ingmarsretro/nixieclock/pictures/acrylcover.jpg

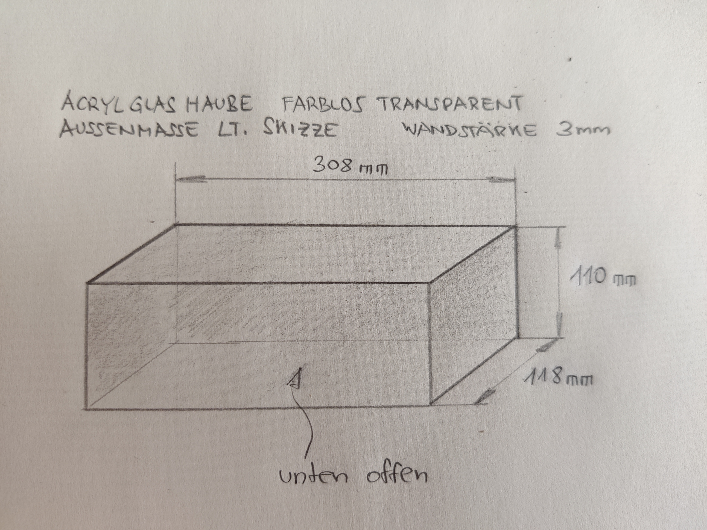
pictures/acrylcover.jpg
