ingmarsretro/nixieclock/pictures/nixieclock.jpg

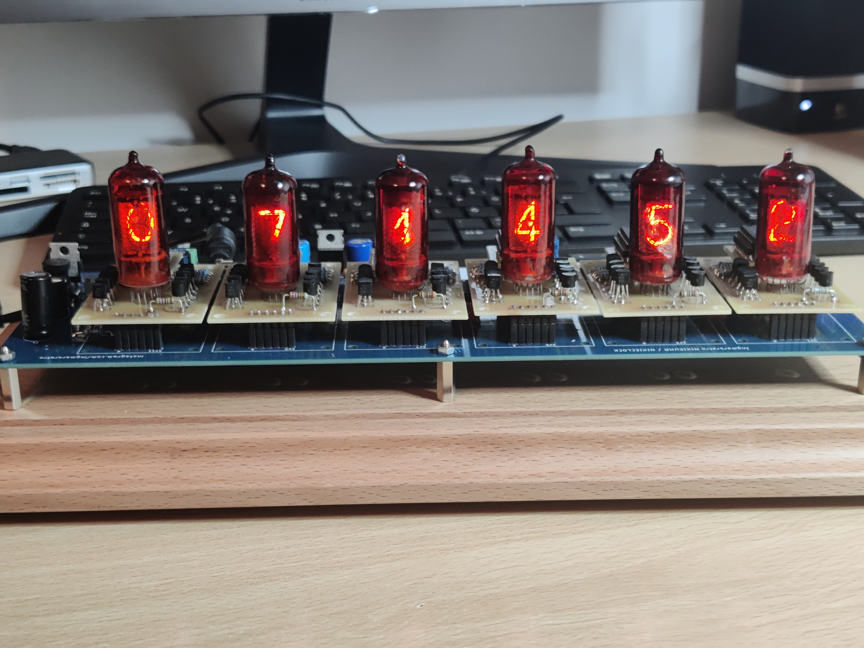
pictures/nixieclock.jpg
