ingmarsretro/nixieclock/README.md

# nixieclock
it is a project for a simple nixieclock hardware and software design based on atmega 8bit controller

develpment environment for this project below:
- Arduino IDE 
- Autodesk Eagle schematic and layout tool for pcb design

all files are hosted here in these folders
