ingmarsretro/nixieclock/board_eagle/Nixieclock_schematic_v3.7.pdf

SpiceOrder 2 | SpiceOrder 1 | SpiceOrder 1 SpiceOrder 2

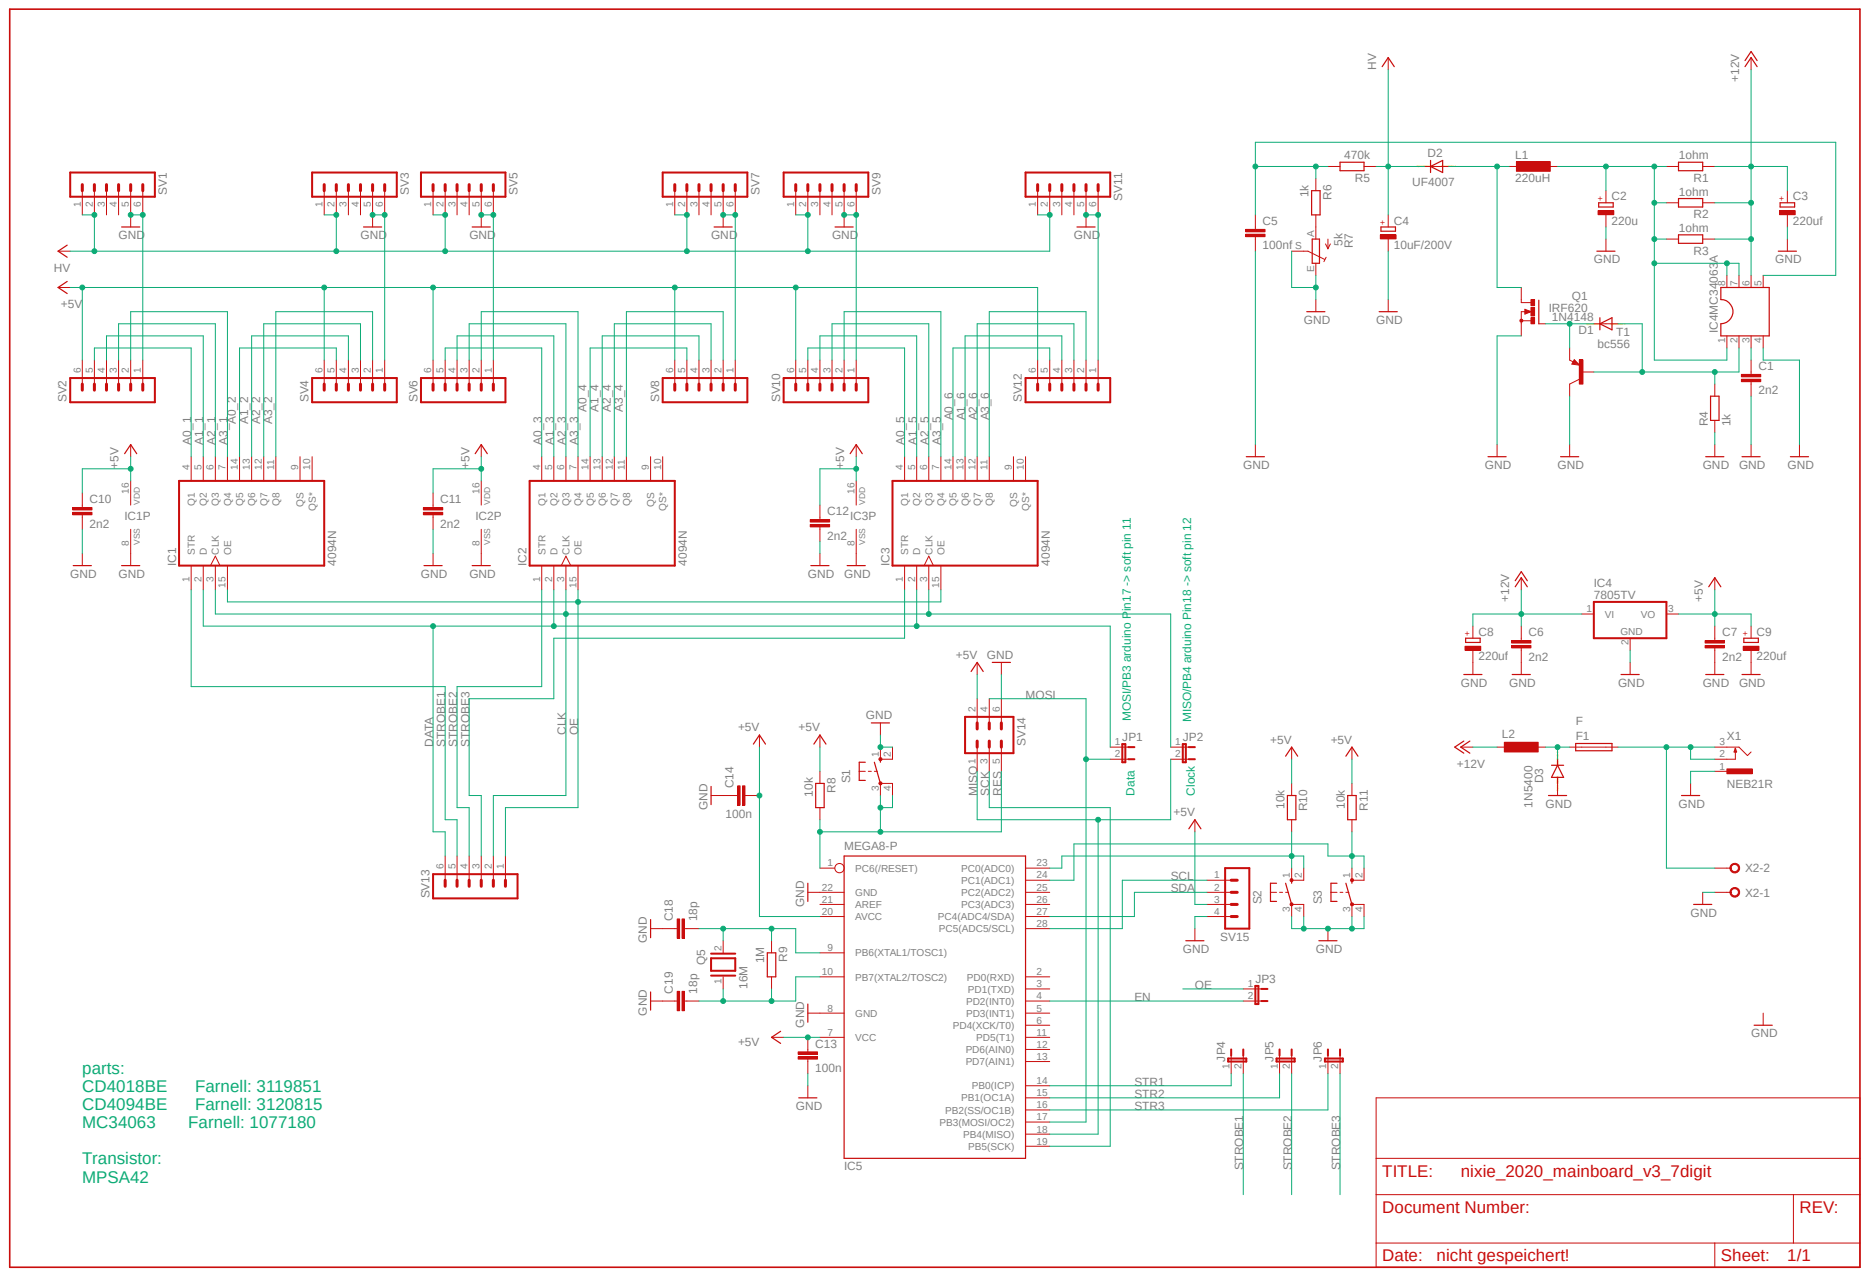
[picture p3: page 1]

9 QS* 10 Q8 11 Q7 12 Q6 13 Q5 14 OE 15 IC1 VDD 8 16 VSS

9 QS* 10 Q8 11 Q7 12 Q6 13 Q5 14 OE 15 IC3 VDD 8 16 VSS

+ MOSI/PB3 arduino Pin17 -> soft pin 11 Data Clock MISO/PB4 arduino Pin18 -> soft pin 12

STR2
STR3

Document Number: | REV:

Date: nicht gespeichert! | Sheet: 1/1
