ingmarsretro/nixieclock/schematics/schematic_mainboard.pdf

SpiceOrder 2 | SpiceOrder 1 | SpiceOrder 1 SpiceOrder 2

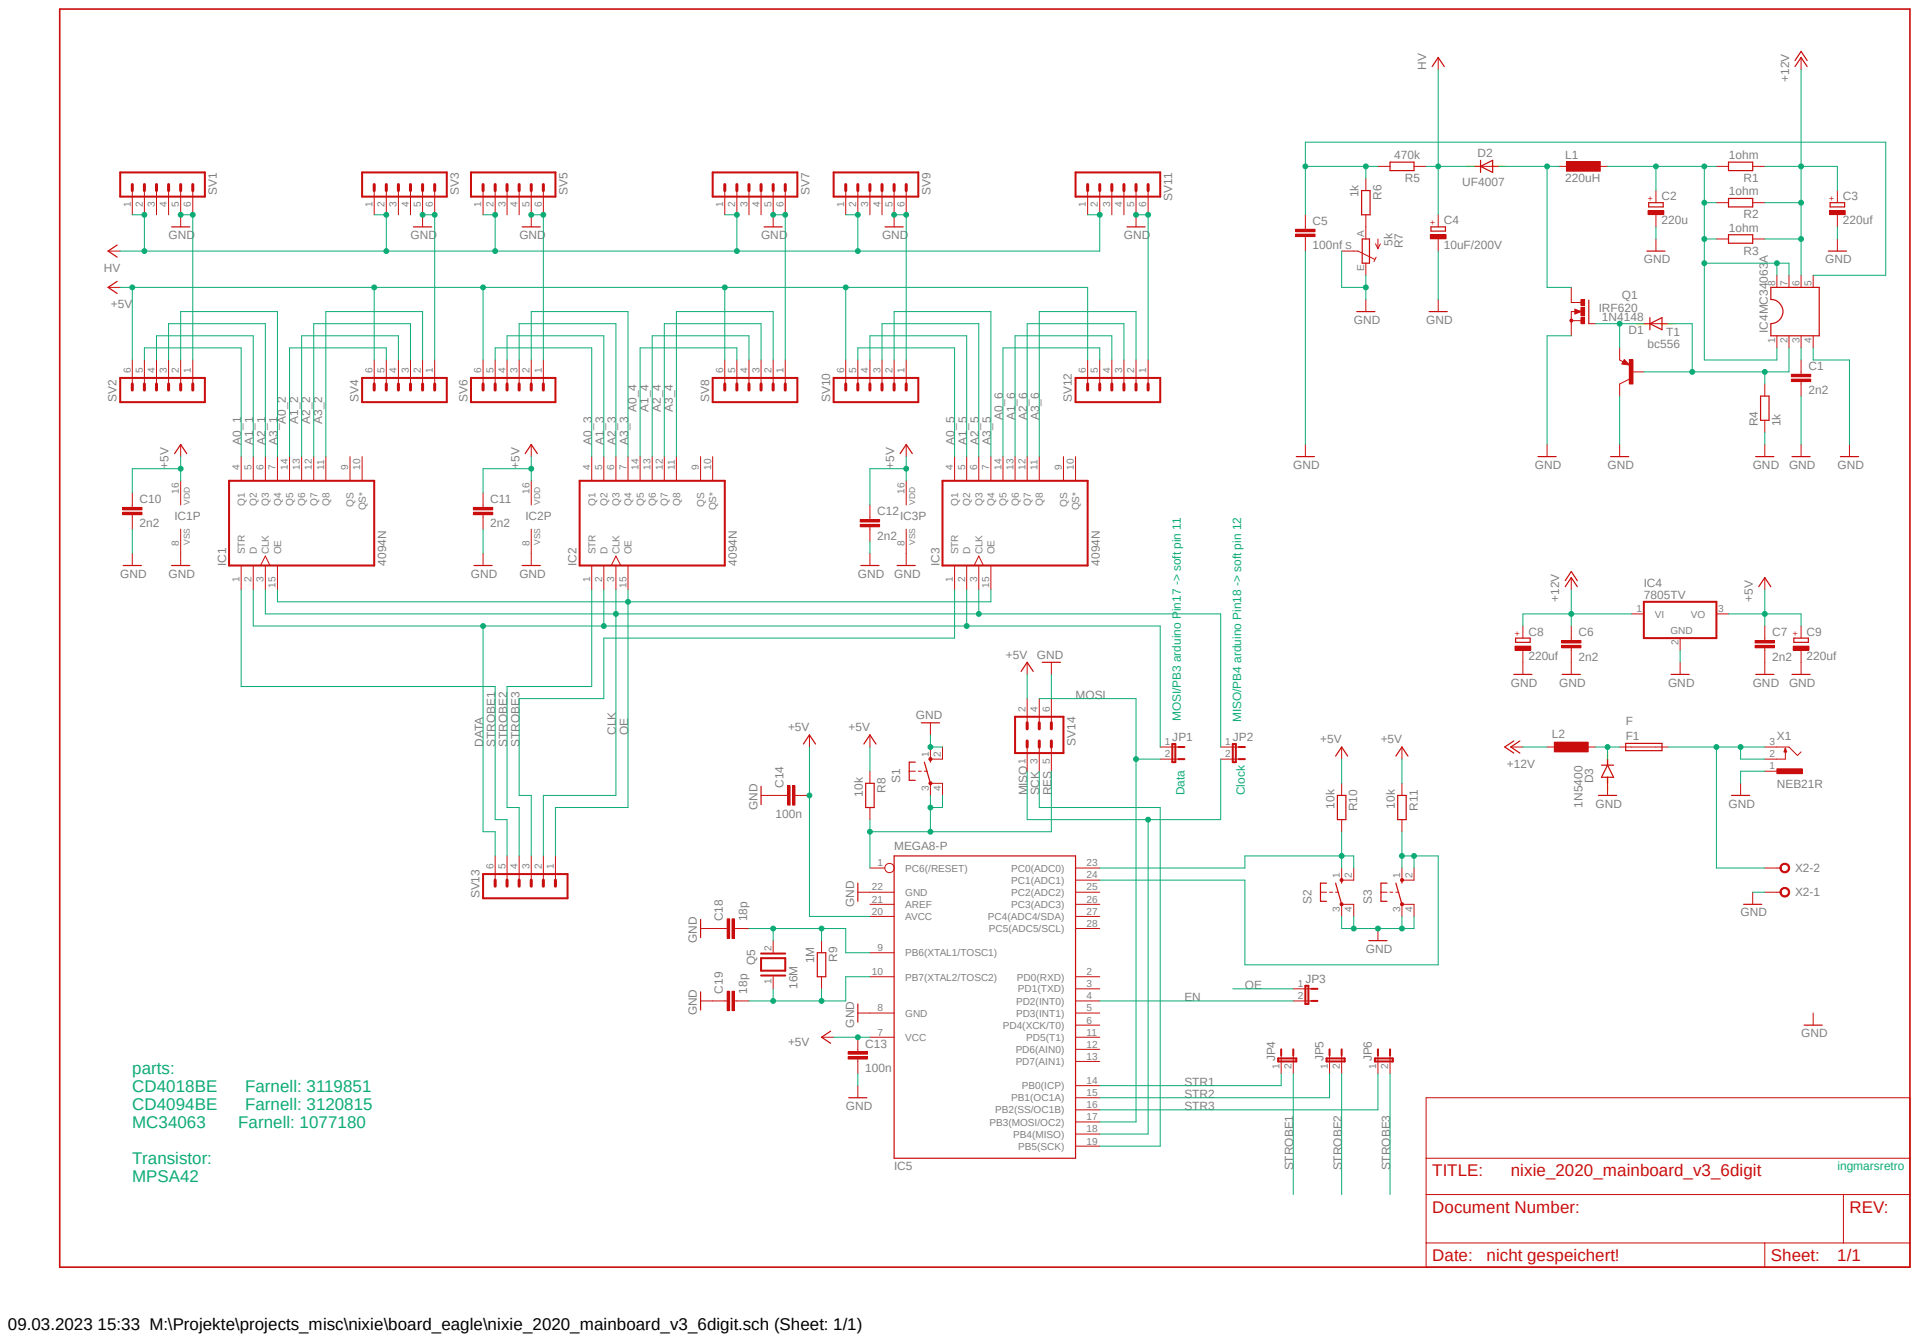
[picture p4: page 1]
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

+ MOSI/PB3 arduino Pin17 -> soft pin 11 Data Clock MISO/PB4 arduino Pin18 -> soft pin 12

STR2
STR3

Document Number: | REV:

Date: nicht gespeichert! | Sheet: 1/1

09.03.2023 15:33 M:\Projekte\projects_misc\nixie\board_eagle\nixie_2020_mainboard_v3_6digit.sch (Sheet: 1/1)
