ingmarsretro/nixieclock/schematics/schematic_tubeboard.pdf

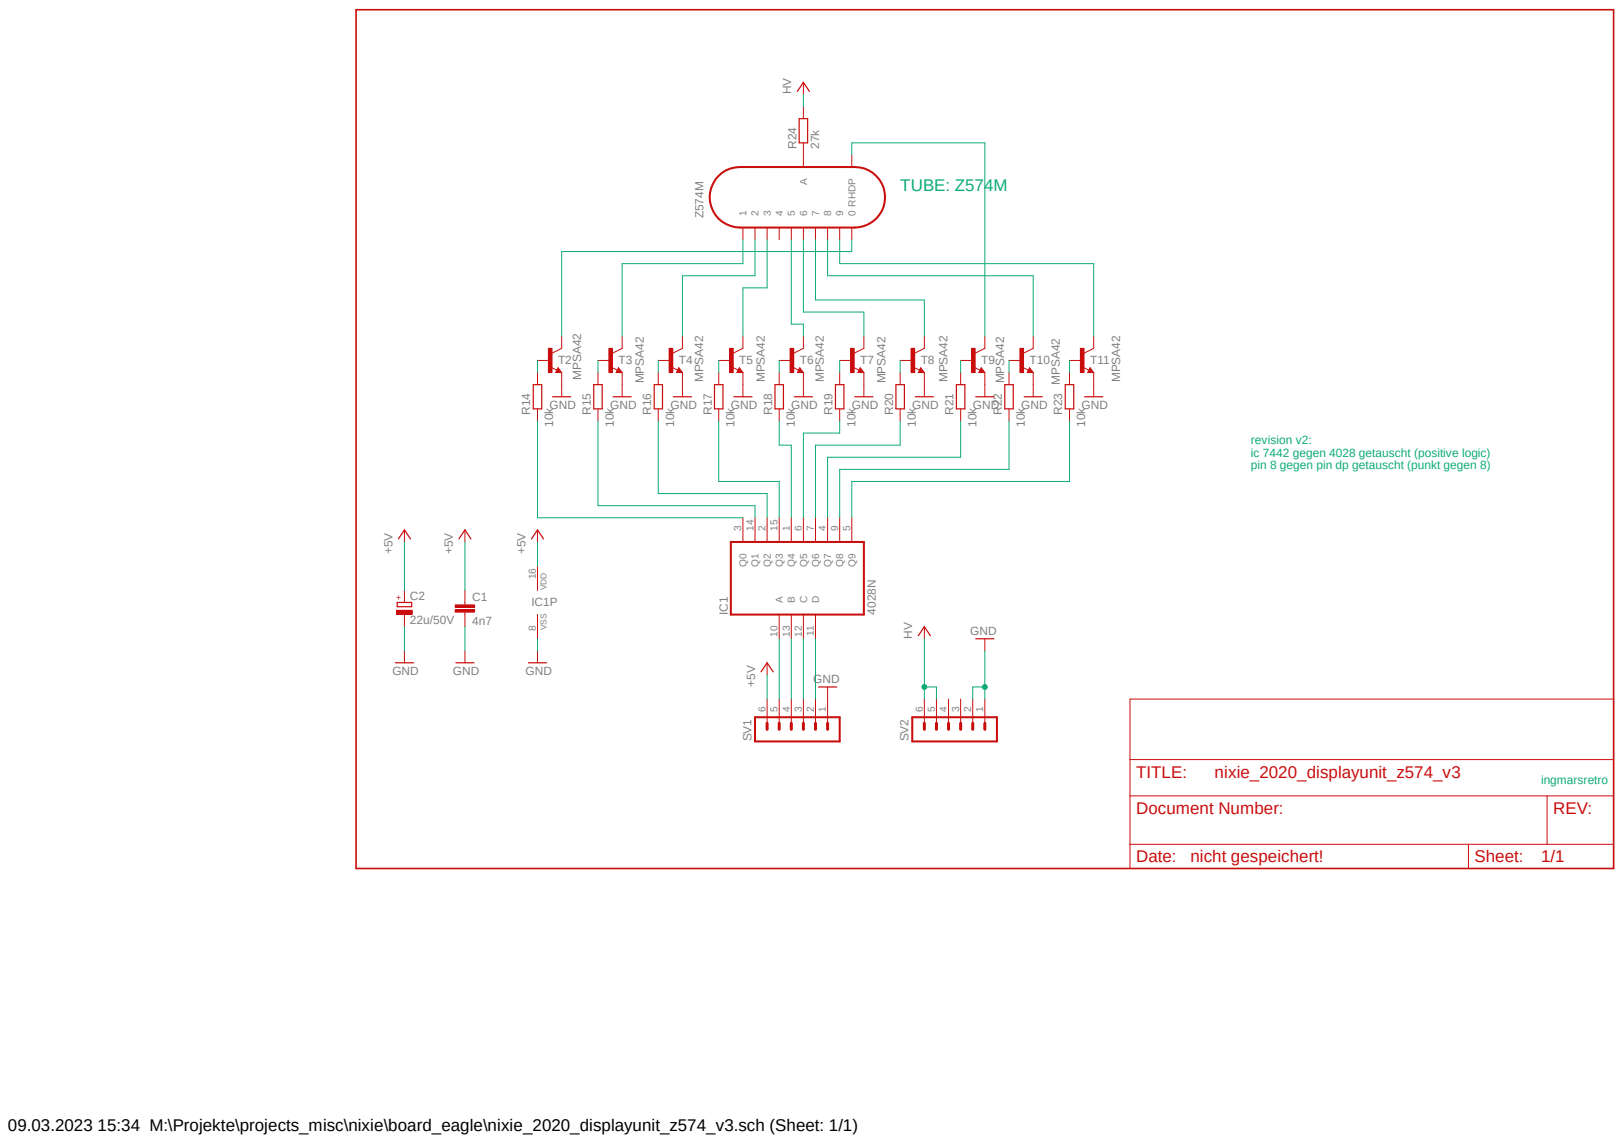
[picture p5: page 1]

revision v2:
ic 7442 gegen 4028 getauscht (positive logic)
pin 8 gegen pin dp getauscht (punkt gegen 8)

Document Number: | REV:

Date: nicht gespeichert! | Sheet: 1/1

09.03.2023 15:34 M:\Projekte\projects_misc\nixie\board_eagle\nixie_2020_displayunit_z574_v3.sch (Sheet: 1/1)
