ingmarsretro/nixieclock/board_eagle/nixie_2020_mainboard_v3_7digit.brd

## EAGLE design board_eagle/nixie_2020_mainboard_v3_7digit.brd (2023-10-31)

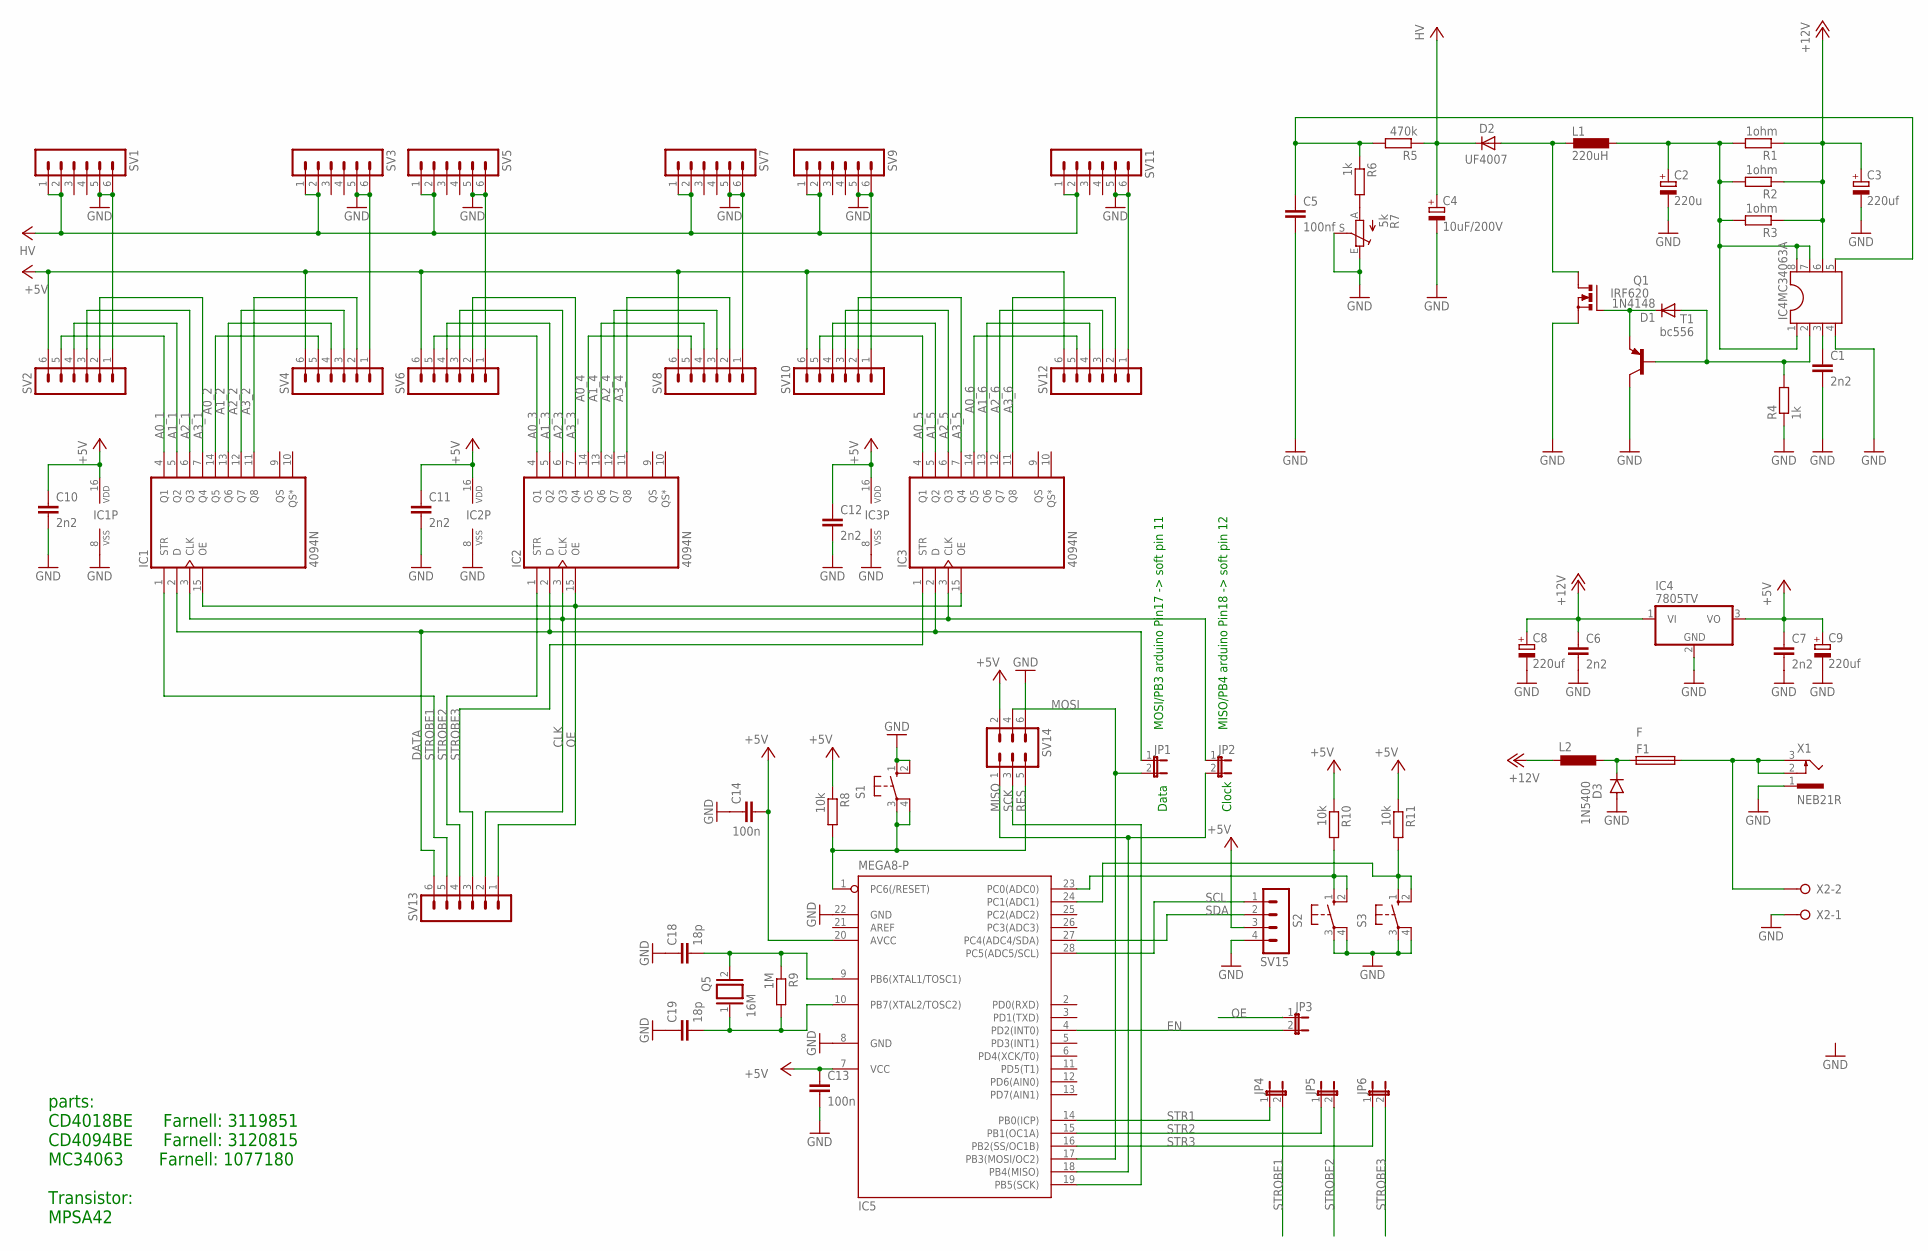
[picture p6: schematic nixie_2020_mainboard_v3_7digit.sch]

Parts:
C1, C6, C7, C10, C11, C12: 2n2; C050-030X075
C2: 220u; E5-10,5
C3, C8, C9: 220uf; E5-10,5
C4: 10uF/200V; E5-10,5
C5: 100nf; C075-042X103
C13, C14: 100n; C050-025X075
C18, C19: 18p; C050-025X075
D1: 1N4148; DO35-10
D2: UF4007; DO35-10
D3: 1N5400; DO201-15
F1: F; SHK20L
IC1, IC2, IC3: 4094N; DIL16
IC4: 7805TV; TO220V
IC4MC34063A: DIL8S; SOCKET-08
IC5: MEGA8-P; DIL28-3
JP1, JP2, JP3, JP4, JP5, JP6: JP1E; JP1
L1: 220uH; LAN02KR
L2: L-EU0207/10; 0207/10
Q1: IRF620; TO220BV
Q5: 16M; QS
R1, R2, R3: 1ohm; 0207/12
R4, R6: 1k; 0207/12
R5: 470k; 0207/12
R7: 5k; RJ9W
R8, R10, R11: 10k; 0207/12
R9: 1M; 0207/12
S1, S2, S3: 10-XX; B3F-10XX
SV1, SV2, SV3, SV4, SV5, SV6, SV7, SV8, SV9, SV10, SV11, SV12, SV13: MA06-1
SV14: MA03-2
SV15: MA04-1
T1: bc556; TO92-EBC
X1: NEB21R
X2: W237-02P; W237-132

Connections:
+5V: C7.1, C9.+, C10.1, C11.1, C12.1, C13.1, C14.2, IC1.16 (VDD), IC2.16 (VDD), IC3.16 (VDD), IC4.3 (VO), IC5.7 (VCC), IC5.20 (AVCC), R8.1, R10.1, R11.1, SV2.6, SV4.6, SV6.6, SV8.6, SV10.6, SV12.6, SV14.2, SV15.3
+12V: C3.+, C6.1, C8.+, IC4.1 (VI), IC4MC34063A.6, L2.1, R1.1, R2.1, R3.1
A0_1: IC1.4 (Q1), SV2.5
A0_2: IC1.14 (Q5), SV4.5
A0_3: IC2.4 (Q1), SV6.5
A0_4: IC2.14 (Q5), SV8.5
A0_5: IC3.4 (Q1), SV10.5
A0_6: IC3.14 (Q5), SV12.5
A1_1: IC1.5 (Q2), SV2.4
A1_2: IC1.13 (Q6), SV4.4
A1_3: IC2.5 (Q2), SV6.4
A1_4: IC2.13 (Q6), SV8.4
A1_5: IC3.5 (Q2), SV10.4
A1_6: IC3.13 (Q6), SV12.4
A2_1: IC1.6 (Q3), SV2.3
A2_2: IC1.12 (Q7), SV4.3
A2_3: IC2.6 (Q3), SV6.3
A2_4: IC2.12 (Q7), SV8.3
A2_5: IC3.6 (Q3), SV10.3
A2_6: IC3.12 (Q7), SV12.3
A3_1: IC1.7 (Q4), SV2.2
A3_2: IC1.11 (Q8), SV4.2
A3_3: IC2.7 (Q4), SV6.2
A3_4: IC2.11 (Q8), SV8.2
A3_5: IC3.7 (Q4), SV10.2
A3_6: IC3.11 (Q8), SV12.2
CLK: IC1.3 (CLK), IC2.3 (CLK), IC3.3 (CLK), JP2.1, SV13.2
DATA: IC1.2 (D), IC2.2 (D), IC3.2 (D), JP1.1, SV13.6
EN: IC5.4 (PD2(INT0)), JP3.2
GND: C1.2, C2.-, C3.-, C4.-, C5.2, C6.2, C7.2, C8.-, C9.-, C10.2, C11.2, C12.2, C13.2, C14.1, C18.1, C19.1, D3.A, IC1.8 (VSS), IC2.8 (VSS), IC3.8 (VSS), IC4.2 (GND), IC4MC34063A.4, IC5.8 (GND), IC5.22 (GND), Q1.S, R4.1, R7.E, R7.S, S1.1 (S), S1.2 (S1), S2.3, S2.4 (P1), S3.3, S3.4 (P1), SV1.5, SV1.6, SV2.1, SV3.5, SV3.6, SV4.1, SV5.5, SV5.6, SV6.1, SV7.5, SV7.6, SV8.1, SV9.5, SV9.6, SV10.1, SV11.5, SV11.6, SV12.1, SV14.6, SV15.4, T1.C, X1.1, X2.1
MISO: IC5.18 (PB4(MISO)), JP2.2, SV14.1
MOSI: IC5.17 (PB3(MOSI/OC2)), JP1.2, SV14.4
unnamed: F1.2A (2), X1.2, X1.3, X2.2
unnamed: D3.C, F1.1A (1), L2.2
unnamed: IC5.24 (PC1(ADC1)), R11.2, S3.1 (S), S3.2 (S1)
unnamed: IC5.23 (PC0(ADC0)), R10.2, S2.1 (S), S2.2 (S1)
unnamed: C18.2, IC5.9 (PB6(XTAL1/TOSC1)), Q5.2, R9.1
unnamed: C19.2, IC5.10 (PB7(XTAL2/TOSC2)), Q5.1, R9.2
unnamed: C1.1, IC4MC34063A.3
unnamed: D1.A, IC4MC34063A.2, R4.2, T1.B
unnamed: D1.C, Q1.G, T1.E
unnamed: D2.A, L1.2, Q1.D
unnamed: C2.+, IC4MC34063A.1, IC4MC34063A.7, IC4MC34063A.8, L1.1, R1.2, R2.2, R3.2
unnamed: C5.1, IC4MC34063A.5, R5.2, R6.1
unnamed: R6.2, R7.A
OE: IC1.15 (OE), IC2.15 (OE), IC3.15 (OE), JP3.1, SV13.1
RES: IC5.1 (PC6(/RESET)), R8.2, S1.3, S1.4 (P1), SV14.5
SCK: IC5.19 (PB5(SCK)), SV14.3
SCL: IC5.28 (PC5(ADC5/SCL)), SV15.1
SDA: IC5.27 (PC4(ADC4/SDA)), SV15.2
STR1: IC5.14 (PB0(ICP)), JP4.1
STR2: IC5.15 (PB1(OC1A)), JP5.1
STR3: IC5.16 (PB2(SS/OC1B)), JP6.1
STROBE1: IC1.1 (STR), JP4.2, SV13.5
STROBE2: IC2.1 (STR), JP5.2, SV13.4
STROBE3: IC3.1 (STR), JP6.2, SV13.3
VCC: C4.+, D2.C, R5.1, SV1.1, SV1.2, SV3.1, SV3.2, SV5.1, SV5.2, SV7.1, SV7.2, SV9.1, SV9.2, SV11.1, SV11.2

Notes on the sheet:
MOSI/PB3 arduino Pin17 -> soft pin 11
Data
Clock
MISO/PB4 arduino Pin18 -> soft pin 12
parts: CD4018BE Farnell: 3119851 CD4094BE Farnell: 3120815 MC34063 Farnell: 1077180 Transistor: MPSA42

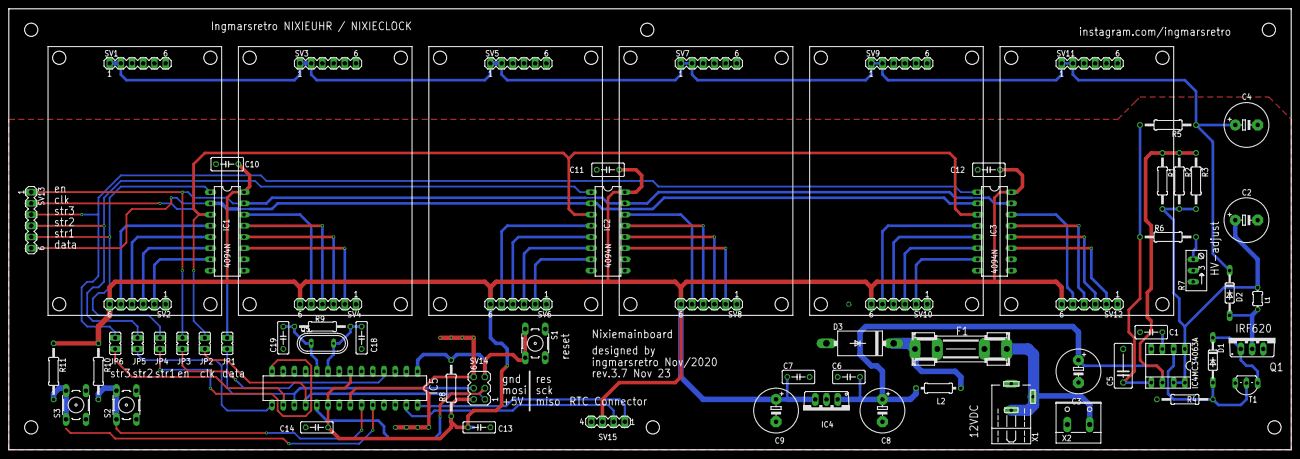
[picture p7: board nixie_2020_mainboard_v3_7digit.brd from above]

Board: 2 copper layers, 290.8 x 100.0 mm, 68 parts (0 on the bottom side), 57 nets.
