ingmarsretro/nixieclock/board_eagle/nixie_2020_displayunit_z574_v3.brd

## EAGLE design board_eagle/nixie_2020_displayunit_z574_v3.brd (2023-03-09)

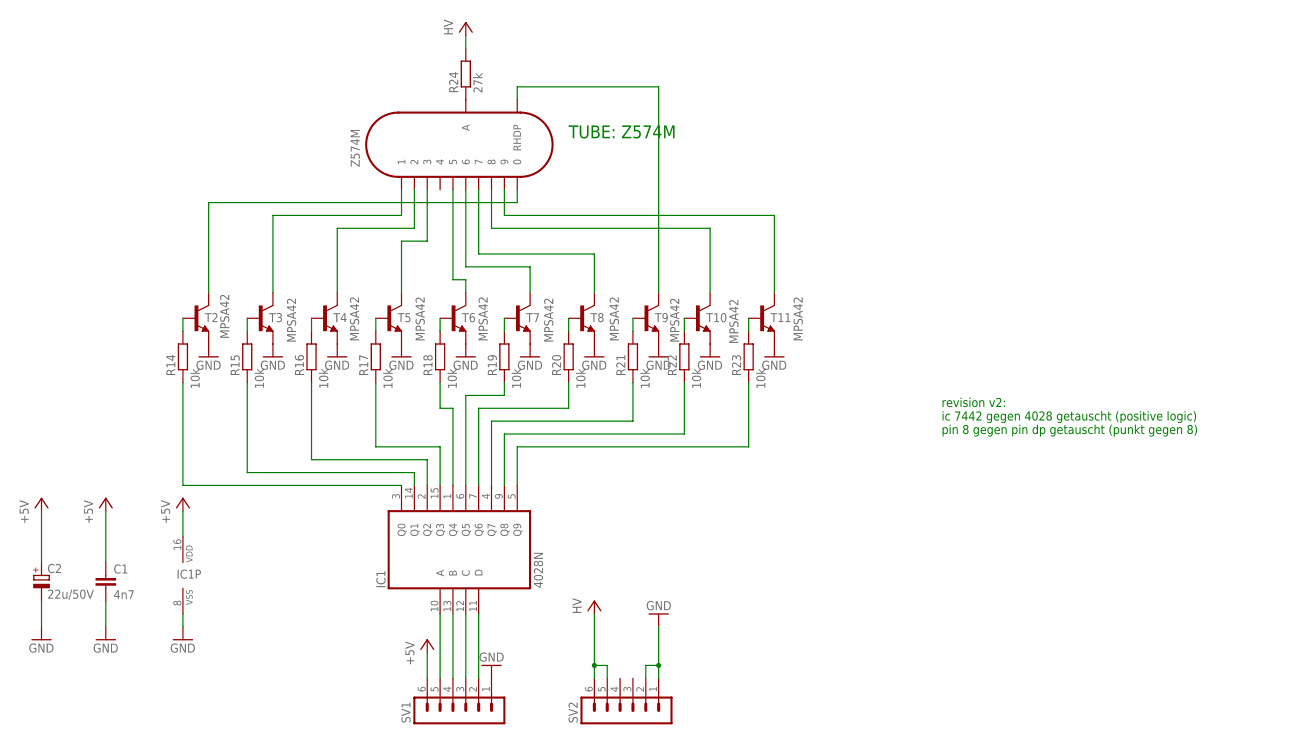
[picture p8: schematic nixie_2020_displayunit_z574_v3.sch]

Parts:
C1: 4n7; C075-032X103
C2: 22u/50V; E5-5
IC1: 4028N; DIL16
R14, R15, R16, R17, R18, R19, R20, R21, R22, R23: 10k; 0207/10
R24: 27k; 0207/10
SV1, SV2: MA06-1
T2, T3, T4, T5, T6, T7, T8, T9, T10, T11: MPSA42; TO92-EBC
Z574M: IN-8-2

Connections:
+5V: C1.1, C2.+, IC1.16 (VDD), SV1.6
GND: C1.2, C2.-, IC1.8 (VSS), SV1.1, SV2.1, SV2.2, T2.E, T3.E, T4.E, T5.E, T6.E, T7.E, T8.E, T9.E, T10.E, T11.E
unnamed: IC1.10 (A), SV1.5
unnamed: IC1.13 (B), SV1.4
unnamed: IC1.12 (C), SV1.3
unnamed: IC1.11 (D), SV1.2
unnamed: T9.C, Z574M.. (RHDP)
unnamed: R14.2, T2.B
unnamed: R15.2, T3.B
unnamed: R16.2, T4.B
unnamed: R17.2, T5.B
unnamed: R18.2, T6.B
unnamed: R19.2, T7.B
unnamed: R20.2, T8.B
unnamed: R21.2, T9.B
unnamed: R22.2, T10.B
unnamed: R23.2, T11.B
unnamed: IC1.3 (Q0), R14.1
unnamed: IC1.14 (Q1), R15.1
unnamed: IC1.2 (Q2), R16.1
unnamed: IC1.15 (Q3), R17.1
unnamed: IC1.1 (Q4), R18.1
unnamed: IC1.6 (Q5), R19.1
unnamed: IC1.7 (Q6), R20.1
unnamed: IC1.4 (Q7), R21.1
unnamed: IC1.9 (Q8), R22.1
unnamed: IC1.5 (Q9), R23.1
unnamed: T3.C, Z574M.1
unnamed: T4.C, Z574M.2
unnamed: T5.C, Z574M.3
unnamed: T6.C, Z574M.5
unnamed: T7.C, Z574M.6
unnamed: T8.C, Z574M.7
unnamed: T10.C, Z574M.8
unnamed: T11.C, Z574M.9
unnamed: T2.C, Z574M.0
unnamed: R24.1, Z574M.A
VCC: R24.2, SV2.5, SV2.6

Notes on the sheet:
revision v2: ic 7442 gegen 4028 getauscht (positive logic) pin 8 gegen pin dp getauscht (punkt gegen 8)
TUBE: Z574M

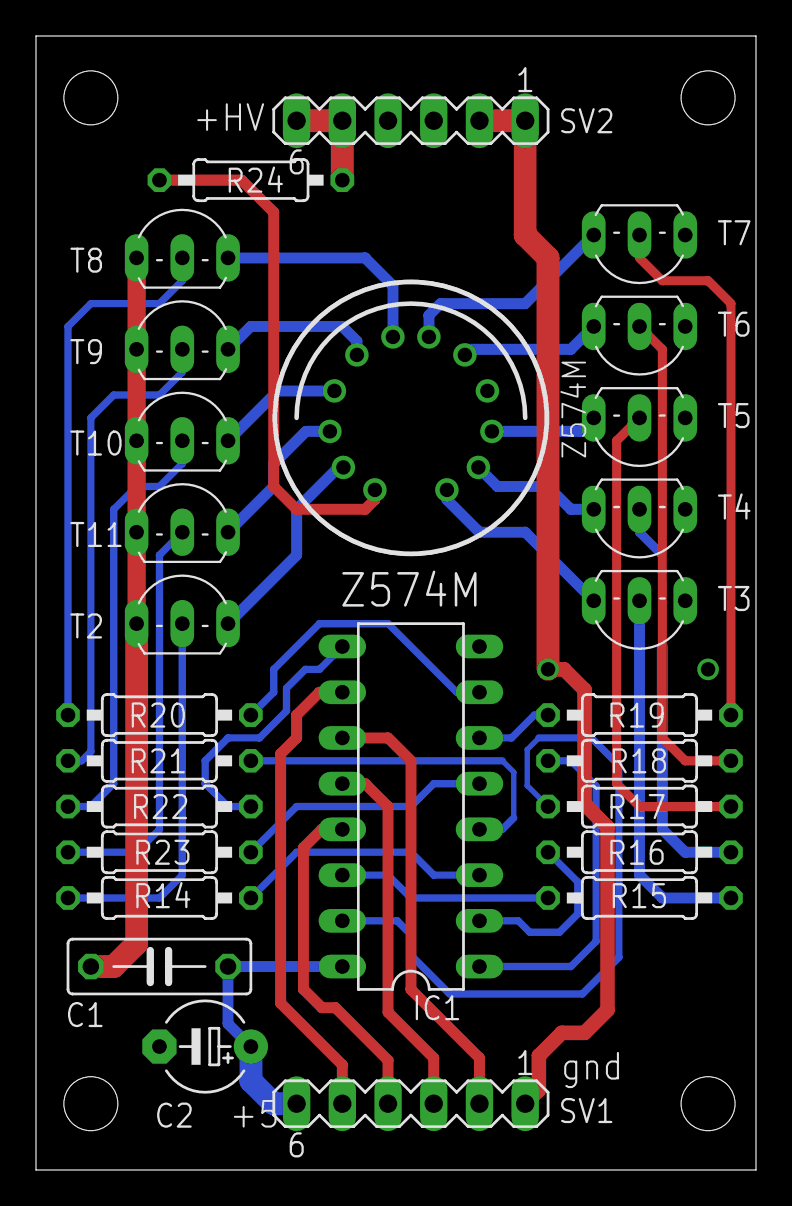
[picture p9: board nixie_2020_displayunit_z574_v3.brd from above]

Board: 2 copper layers, 40.0 x 63.0 mm, 27 parts (0 on the bottom side), 38 nets.
