ingmarsretro/nixieclock/(commit log)

2023-03-09 Create schematic
2023-10-31 Add files via upload
    this Arduino script works with DS1307 RTC-Clock chip.
    the I2C io´s of the DS1307 must be attached to the ATMEGA pins 28(SCL) and 27(SDA)
2023-10-31 Add files via upload
    updated schematic for use of the DS1307 RTC Board
2023-10-31 Add files via upload
    Updated board and schematic files with RTC connector
    [nixie_2020_mainboard_v3_7digit.brd, nixie_2020_mainboard_v3_7digit.sch]
